WRtidE/Robot_Arm_1.0/img/sss.bmp

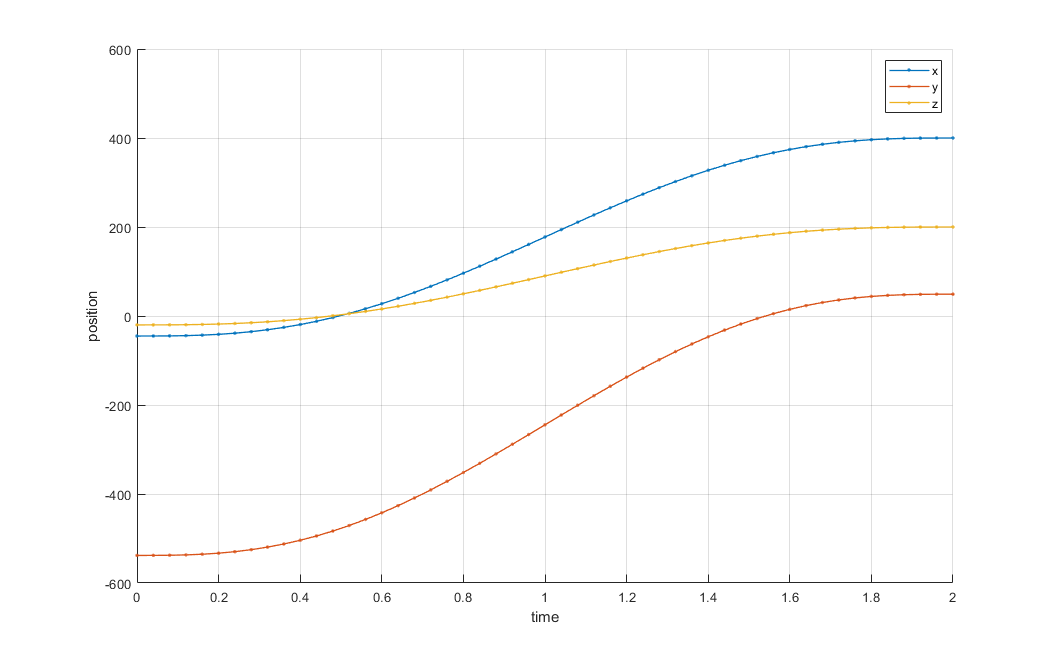
img/sss.bmp
