WRtidE/Robot_Arm_1.0/img/traj.png

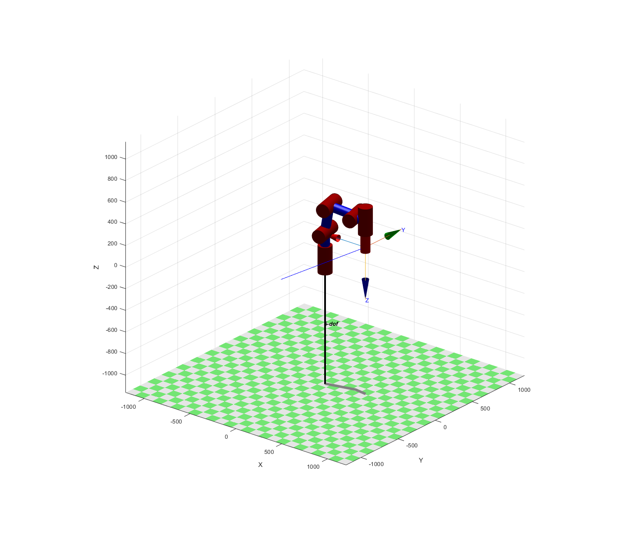
img/traj.png
