WRtidE/Robot_Arm_1.0/img/函数验证.png

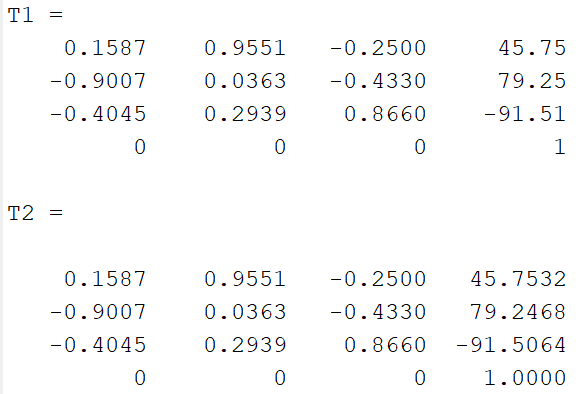
img/函数验证.png
