WRtidE/Robot_Arm_1.0/img/建立DH表2.png

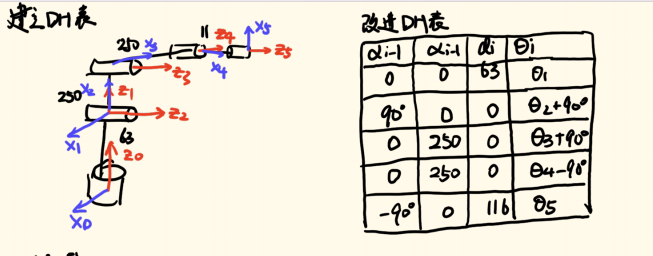
img/建立DH表2.png
