WRtidE/Robot_Arm_1.0/img/机械臂工作空间1.bmp

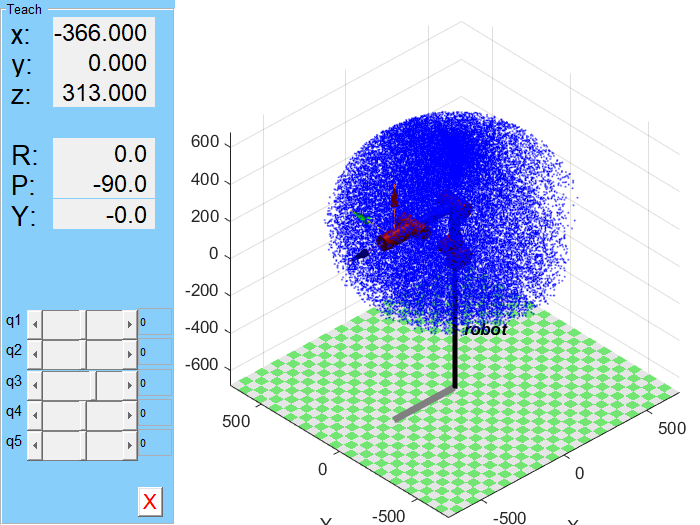
img/机械臂工作空间1.bmp
