WRtidE/Robot_Arm_1.0/img/机械臂工作空间2.bmp

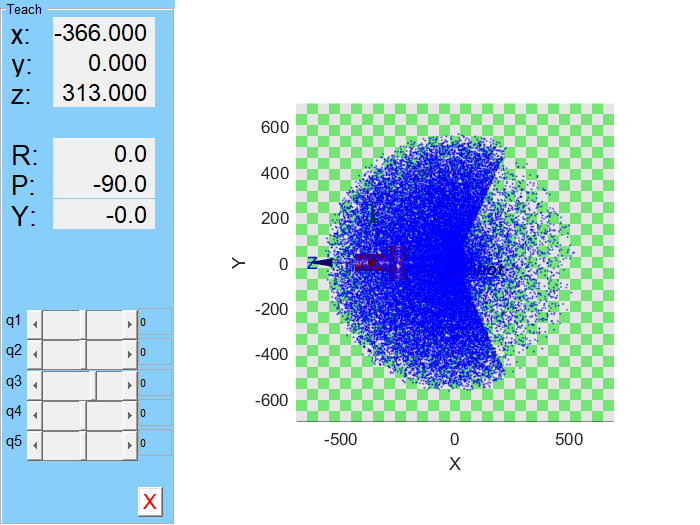
img/机械臂工作空间2.bmp
