WRtidE/Robot_Arm_1.0/img/机械臂正解.jpg

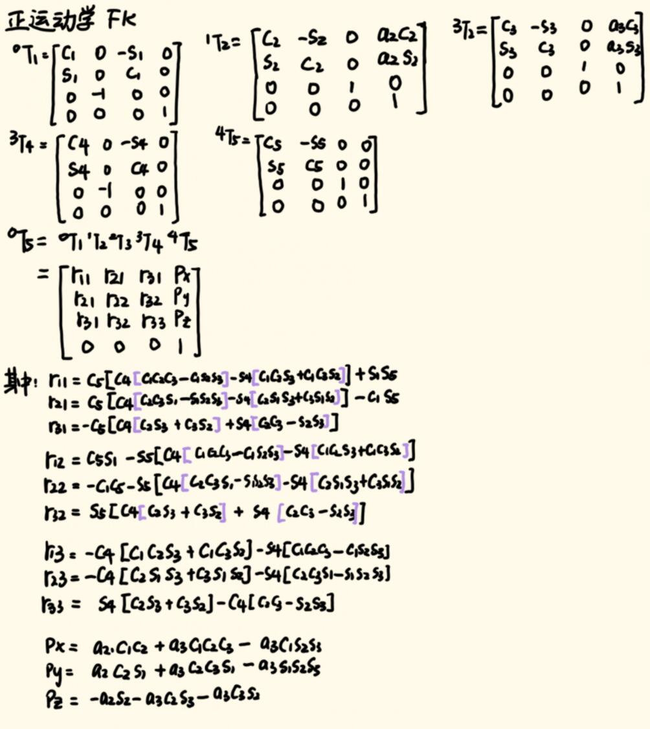
img/机械臂正解.jpg
