WRtidE/Robot_Arm_1.0/img/机械臂逆解.jpg

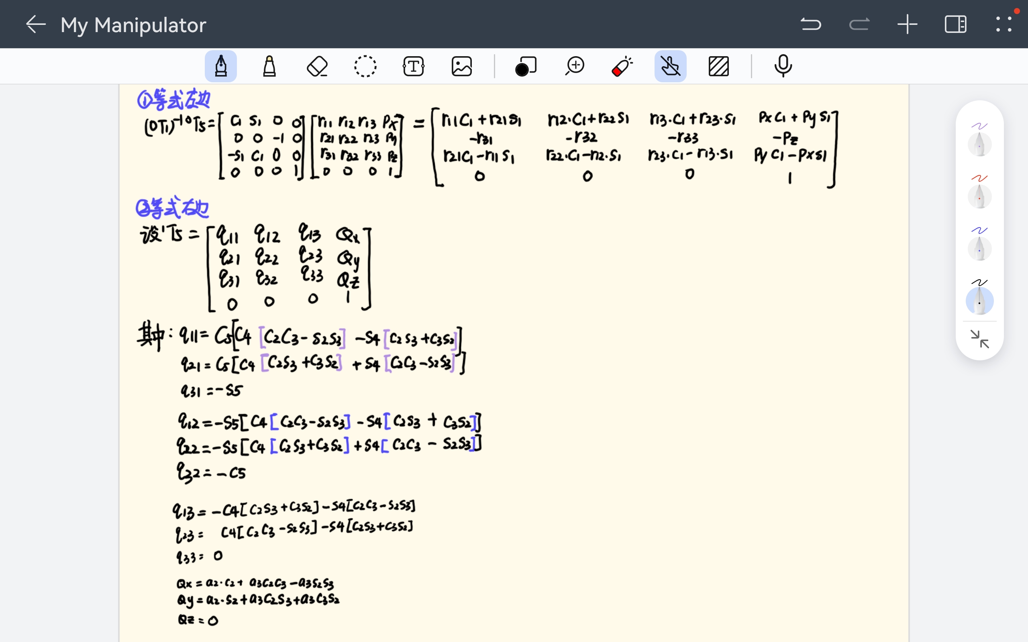
img/机械臂逆解.jpg
