WRtidE/Robot_Arm_1.0/img/正解.png

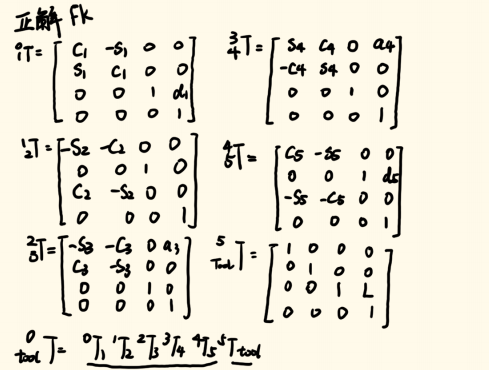
img/正解.png
