WRtidE/Robot_Arm_1.0/整体结构图.png

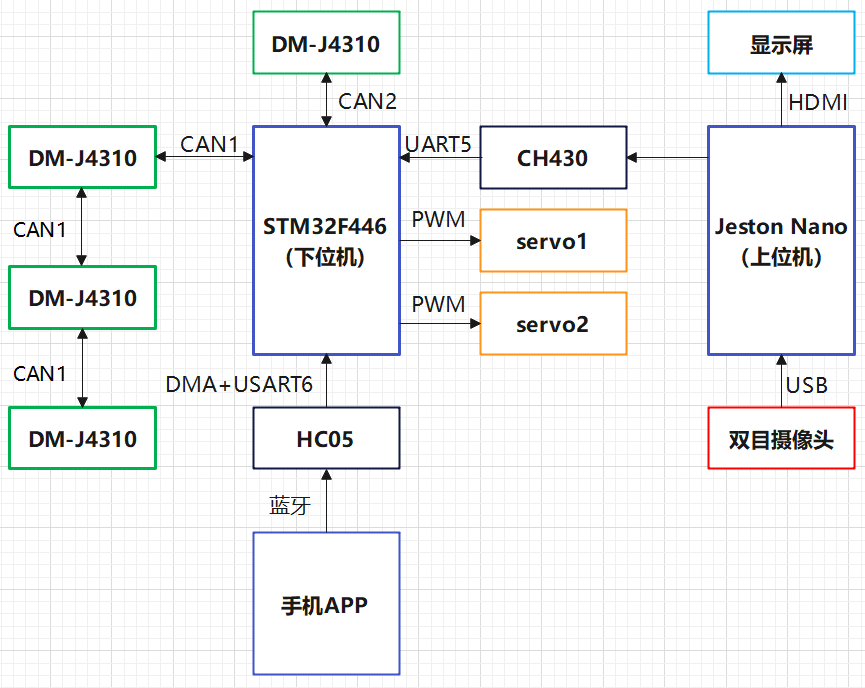
整体结构图.png
