WRtidE/Robot_Arm_1.0/Robotic_Arm/Robotic_Arm.ioc

Mcu.UserName=STM32F446RCTx
PA13.Signal=SYS_JTMS-SWDIO
PA14.Signal=SYS_JTCK-SWCLK
PB12.Signal=CAN2_RX
PB13.Signal=CAN2_TX
PB8.Signal=CAN1_RX
PB9.Signal=CAN1_TX
PC0.GPIO_Label=LED
PC0.Signal=GPIO_Output
PC12.Signal=UART5_TX
PC13.GPIO_Label=MOTOR_1
PC13.Signal=GPIO_Output
PC14-OSC32_IN.GPIO_Label=VCC_5V
PC14-OSC32_IN.Signal=GPIO_Output
PC4.GPIO_Label=MOTOR_2
PC4.Signal=GPIO_Output
PC6.Signal=USART6_TX
PC7.Signal=USART6_RX
PC8.Signal=S_TIM3_CH3
PC9.Signal=S_TIM3_CH4
PD2.Signal=UART5_RX
PH0-OSC_IN.Signal=RCC_OSC_IN
PH1-OSC_OUT.Signal=RCC_OSC_OUT
