WRtidE/Robot_Arm_1.0/Robotic_Arm/Inc/main.h

#define MOTOR_1_Pin GPIO_PIN_13
#define MOTOR_1_GPIO_Port GPIOC
#define VCC_5V_Pin GPIO_PIN_14
#define VCC_5V_GPIO_Port GPIOC
#define LED_Pin GPIO_PIN_0
#define LED_GPIO_Port GPIOC
#define MOTOR_2_Pin GPIO_PIN_4
#define MOTOR_2_GPIO_Port GPIOC
