WRtidE/Robot_Arm_1.0/Robotic_Arm/MDK-ARM/App/path_planning.c

#include "stm32f4xx.h" 
#include "path_planning.h"
#include "cmsis_os.h"
#include "Can_user.h"
#include "Servos.h"

static float pi=3.1415;
float delay_time = 0;
float res = 1;
float ts=0;
float tf=0;
float a0,a1,a2,a3,a4,a5 = 0;
float q0,qf,dq0,dqf,ddq0,ddqf = 0; 
//===============================计算N次方==============================================================
//計算n次方
float power(float num,uint16_t n)
{
	res = 1;
	for(uint16_t i =0;i<n;i++)
	{
		res = res * num;
	}	
	
	return res;
}


//===============================直接传入两个点，生成这两个点之间所有关节相对路径==============================================================
//需要传入两个点的角度信息，这条轨迹的时间信息，共三个数据
void one_path_cala(path *path)
{
  ts   = path->t_s;
	tf   = path->t_f;
	
	for(uint16_t i = 0;i<4;i++)
	{
		q0   = path->start.theta[i];
		qf   = path->end.theta[i];
		dq0  = path->start.vel[i];
		dqf  = path->end.vel[i];
		ddq0 = path->start.acc[i];
		ddqf = path->end.acc[i];

		//计算轨迹五次多项式系数值	
		a0 = q0;
		a1 = dq0;
		a2 = ddq0/2;
		a3 = (20*(qf-q0)-( 8*dqf + 12*dq0)*(tf-ts) - (3*ddq0 -   ddqf)*(tf-ts)*(tf-ts))/(2*(tf-ts)*(tf-ts)*(tf-ts));
		a4 = (30*(q0-qf)+(14*dqf + 16*dq0)*(tf-ts) + (3*ddq0 - 2*ddqf)*(tf-ts)*(tf-ts))/(2*(tf-ts)*(tf-ts)*(tf-ts)*(tf-ts));
		a5 = (12*(qf-q0)-( 6*dqf +  6*dq0)*(tf-ts) - (  ddq0 -   ddqf)*(tf-ts)*(tf-ts))/(2*(tf-ts)*(tf-ts)*(tf-ts)*(tf-ts)*(tf-ts));
		
		uint16_t index = 0;
		//算出轨迹角度、速度和加速度
		for(float t = ts; t < tf ; t+=(tf-ts)/100)
		{
				 //角度計算
				 path->joint_path[i].theta[index] =  a0+a1*(t-ts)+a2*power((t-ts),2)+a3*power((t-ts),3)+a4*power((t-ts),4)+a5*power((t-ts),5);
				 //速度計算
				 path->joint_path[i].vel[index]   =  a1+2*a2*(t-ts)+3*a3*power((t-ts),2)+4*a4*power((t-ts),3)+5*a5*power((t-ts),4);
				 //加速度计算
				 path->joint_path[i].acc[index]   =  2*a2+6*a3*(t-ts)+12*a4*power((t-ts),2)+20*a5*power((t-ts),3);
				 index++;
		}		
	}
}


//===============================根据规划的路径，改变关节的target_angle==============================================================
void path_planning(path *path)
 {
	 //创建一条路径，先计算
  one_path_cala(path);
	 
	 //算完后再执行路径规划
	for(int index =0;index<100;index++)
	{
		//对角度值进行处理，将电机角度与MATLAB仿真中的角度一一对应
		//将目标角度值赋给电机		
		motor_info[0].target_angle =  path->joint_path[0].theta[index];
		motor_info[1].target_angle = -path->joint_path[1].theta[index];
		motor_info[2].target_angle =  path->joint_path[2].theta[index];
		motor_info[3].target_angle = -path->joint_path[3].theta[index];	
		delay_time = (path->t_f - path->t_s)*10;
		osDelay(delay_time);
	}
 }

 
