WRtidE/Robot_Arm_1.0/Robotic_Arm/MDK-ARM/DriverLayer/Uart_user.h

#ifndef UART_USER_H
#define UART_USER_H
#include "Uart_user.h"

void data_send();
void data_receive();

//�жϷ��ͷ�ʽ
void data_send_IT();
void data_receive_IT();
void send_packet();

typedef __packed struct
{
  int16_t x;
	int16_t y;
	int16_t z;
	

} App_Data;

extern App_Data app_data;

#endif
