WRtidE/Robot_Arm_1.0/(commit log)

2024-04-07 add servo
2024-05-23 “解决多解问题”
2024-06-09 “2024/6/10”
