WRtidE/Robot_Arm_1.0/(notices)

Notices in the files:
Robotic_Arm/Inc/main.h:
Copyright (c) 2024 STMicroelectronics.
All rights reserved.
This software is licensed under terms that can be found in the LICENSE file
